bitflippersanonymous/fpga-camera/docs/Presentation.pdf

## FPGA Based Digital Camera

Ryan Henderson
February 10, 2013

## Digital Imaging

λ Real time video capture
λ CMOS Image Sensor
λ FPGA
λ External Memory
λ PC or Monitor Display
λ Image Sensor Evaluation Kit

## Presentation Overview

λ External Hardware
– Image Sensor
– XSA-100

λ FPGA Design
– Parallel Port
– Master Control
– Memory Control
– SDRAM
– I2C
– Image Sensor Data
Reader

λ Host PC Software
– Save Pictures as JPG /
BMP
– Control Image Sensor

## External Hardware

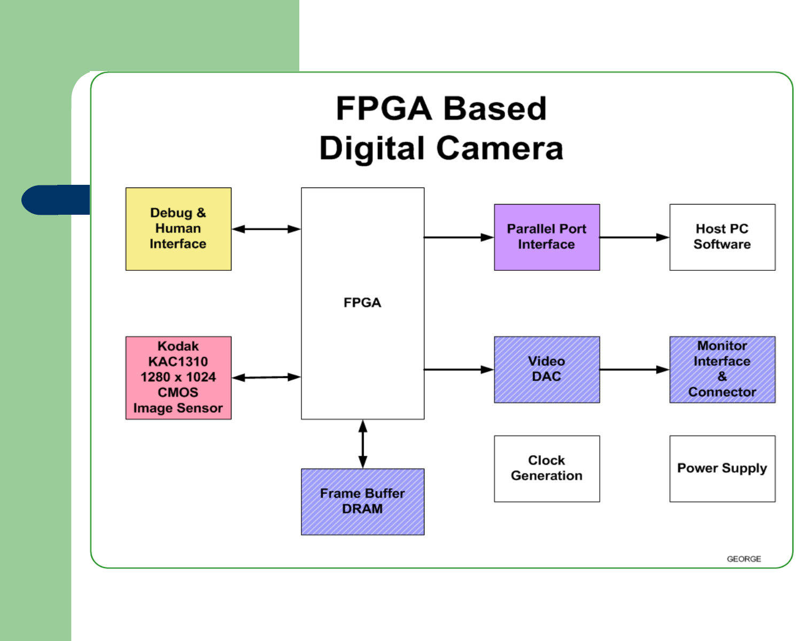
[picture p13: page 5]

## Image Sensor

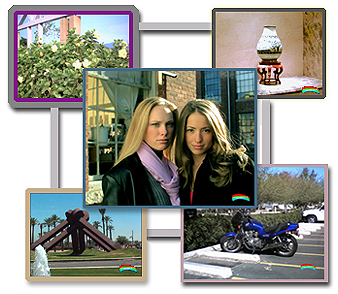
[picture p14: figure]

λ Motorola ImageMOS TM
MCM20027

λ Kodak Digital Science TM KAC – 1310

## Image Sensor Features

λ 1280 x 1024 Pixels Resolution
λ Continuous / Single Shutter Modes
λ 10-bit, RSD ADC Analog to Digital Converter
λ 48-pin Ceramic LCC Package
λ Digitally Programmable via I2C Interface
λ 10/15 fps full SXGA at 13/20Mhz Master Clock Rate λ Bayer-RGB Color Filter Array
λ 3.3V Analog and 3.3V Digital at 250mW Operation λ Camera on a Chip

## Feature Notes

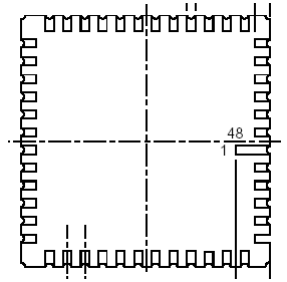
[picture p15: figure]

λ 1280 x 1024 x 10bits x 15fps = 196 608 000 Mbps
λ Sub sample and window of interest (WOI)
λ Surface mount Leadless
Chip Carrier

## Plastronics Socket

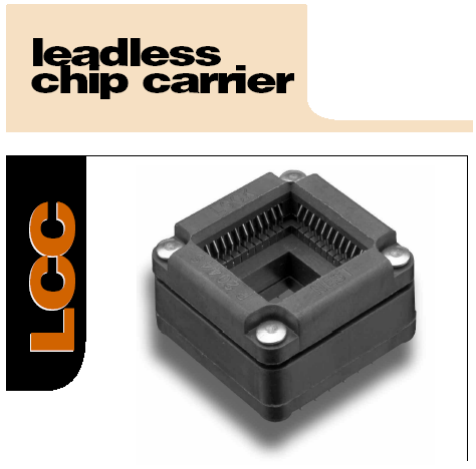
[picture p16: figure]

λ Zero insertion force
λ Strange bottom pin out
λ Required adaptor to .1”
hole spacing
λ Only socket available
under $250

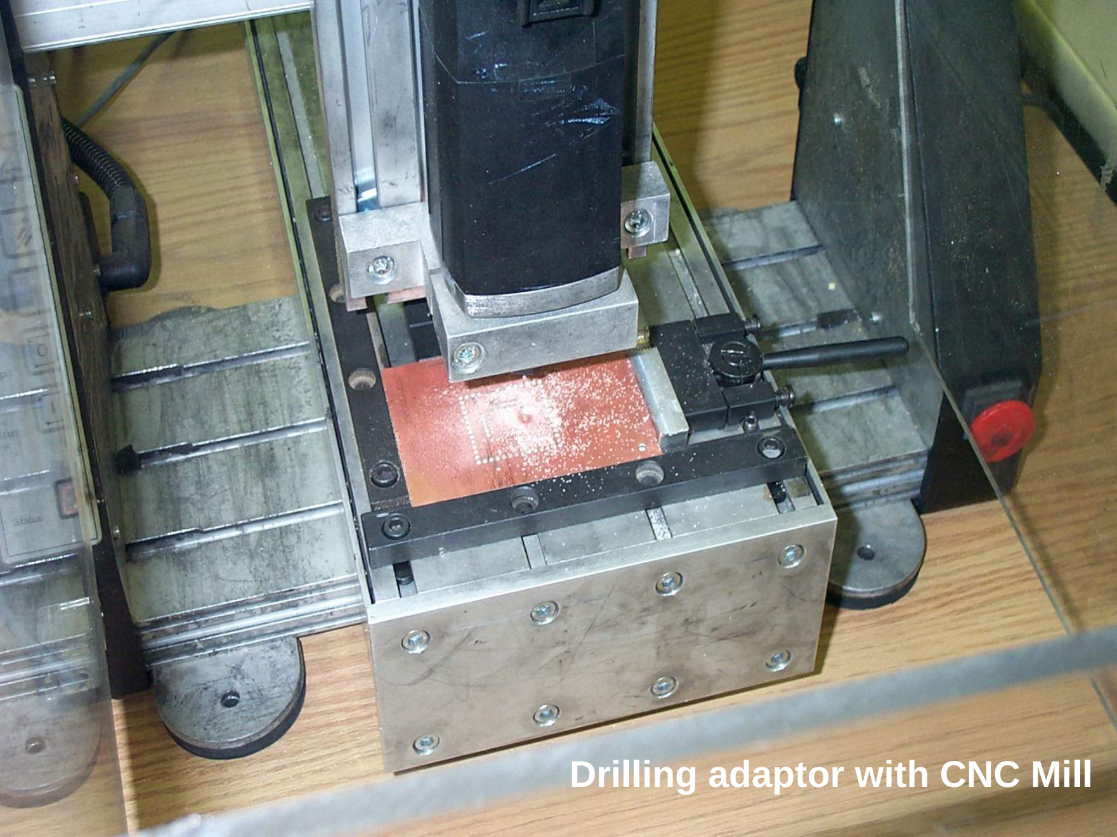
[picture p17: page 10]

Drilling adaptor with CNC Mill

## Sunex Lens

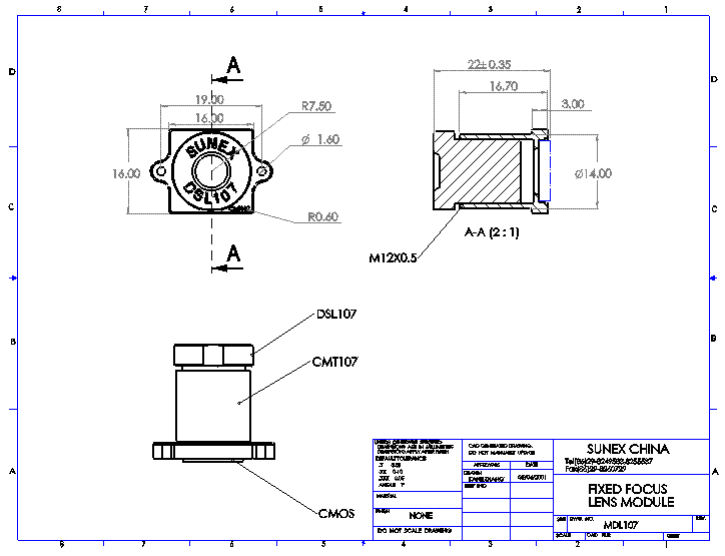
[picture p18: figure]

λ Blurry image
without lens
λ Matches
– F stop
– Focal Length
– Center of Sensor
λ Plastic

## Bayer RBG Color Microlenses

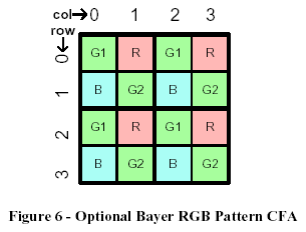
[picture p19: figure]

λ Twice as many green
pixels

λ Combine set of 4 to get
RGB value

## Control Registers

λ 41 8-bit Registers
λ Analog adjustment
– Exposure, white balance etc λ Digital functions / sensor interface – Zoom, pan, sub-sample
λ Column offsets for WOI

## FPGA Development Board

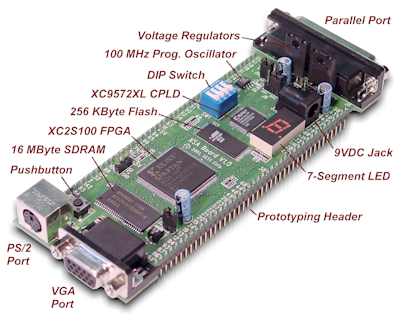
[picture p20: figure]

λ Xess XSA-100
λ Spartan 2
λ 16Mb SDRAM
λ 100MHz Osc.
λ Parallel Port
λ 84 Pin Prototype
Header

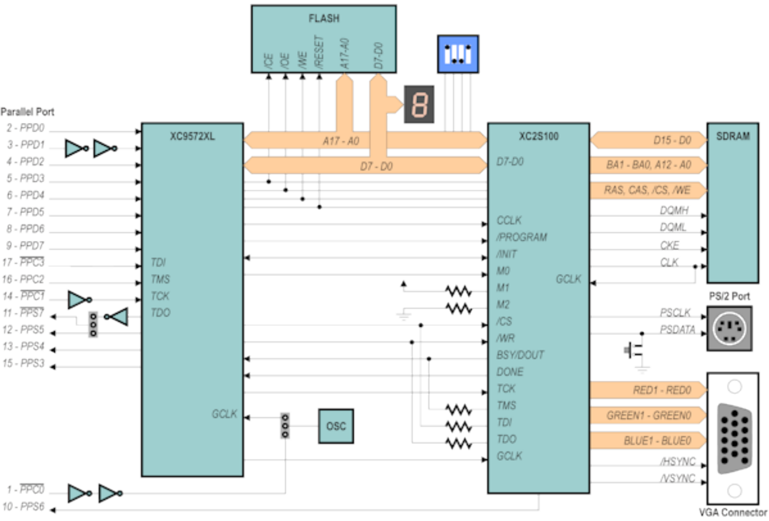
[picture p21: page 15]

## XC2S100 Spartan 2

λ 100k System Gates
λ 40k Bits Block SelectRAM+ λ 38k Distributed RAM
λ 4 Global Clocks
λ 4 Delay Locked Loops
λ 2.5V, 3.3V or 5V I/O
λ Altera Flex 10K70
– 4x Slower
– 18k total RAM

## SDRAM

λ Hynix HY57V281620A
λ 4 Banks x 2M x 16bits
λ PC133 CAS 2
λ External PCB Clock Feedback λ Prebuilt Xess VHDL Interface

## FPGA Design

## Planned Top Level

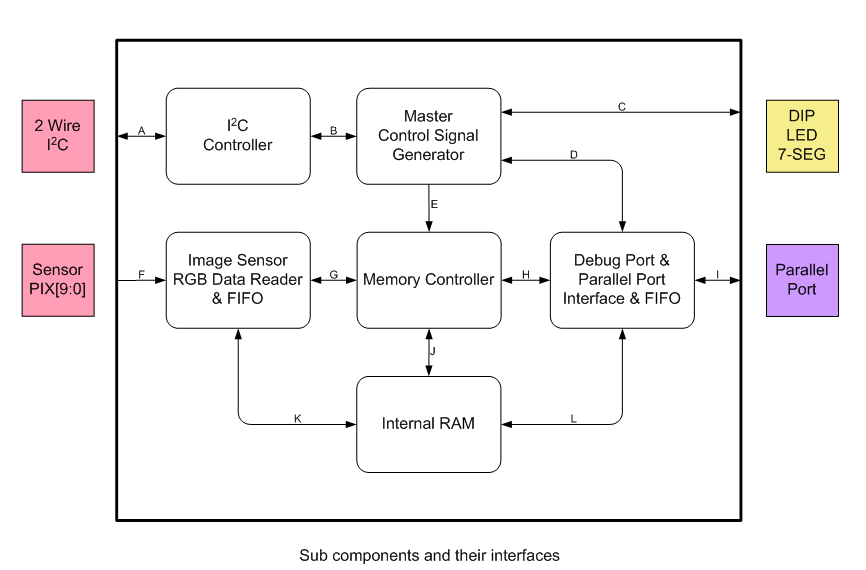
[picture p22: figure]

## Parallel Port Module

λ Connects through PLD to PC parallel port
λ 6 Download data lines d6 – d0
– Line d7 controls reconfiguration of Spartan λ 4 Upload Lines
λ Data Strobe controlled by PC
λ Receives commands from PC to:
– Set / Read registers in image sensor – Upload from RAM
λ 17,000 Gates

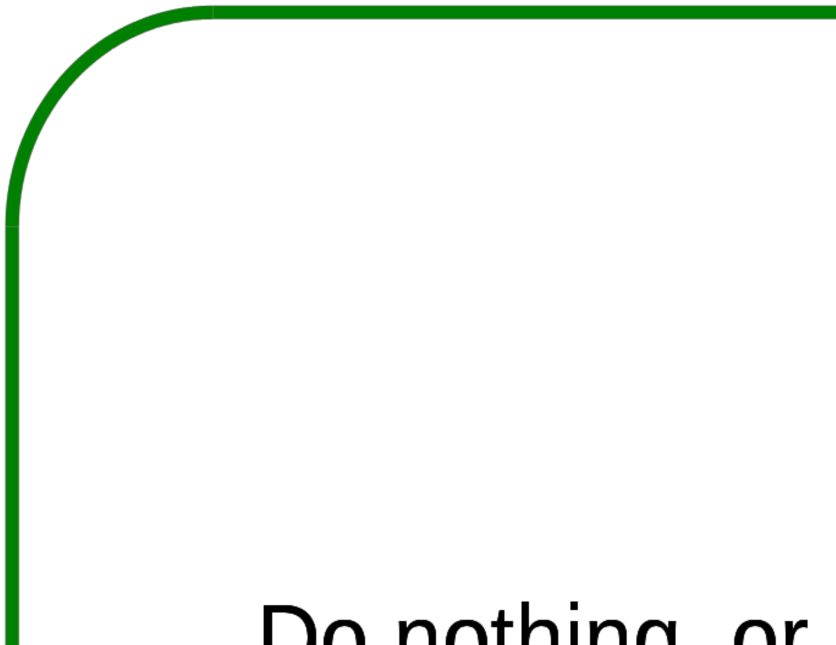
[picture p23: page 21]

## Parallel Port Upload

λ XSA-100 limitation, only upload using status pins λ Debounced strobe signal
λ DDR upload 4 bits / clock edge
λ ~150K bytes/sec
λ Asynchronous Coregen FIFO
– 16 bits 50MHz in
– 4 bits ~75kHz out
λ Counter determines memory addresses

## Parallel Port Download

λ Commands and addresses received
λ Latched and sent to Master Control Signal Generator

## Master Control Signal Generator

λ State machine
λ Branches to receive commands from PC λ Controls Memory Controller
– Sends start address, end address for upload λ Relay data between PC and image sensor through I2C interface

## Memory Controller

λ Arbitration between different components that access the memory
λ Interleaved memory read and write operations
λ Connected to internal RAM or SDRAM controller

## SDRAM Controller

λ Sample VHDL code from XESS
– 100ns Access
– No Burst Mode
– Incorrectly set Mode Register
λ If then else state machine implementation λ Example of DLL use
λ Modify to fit project needs
λ 16, 000 Gates

## SDRAM Controller Problems

λ Errors in code
λ Would synthesize in Leonardo but fail Xilinx place and route
λ Had to move I/O buffer instantiations to top level

I2C

λ CoolRunner XPLA3 I2C bus controller implementation from Xilinx
λ App note XAPP333
λ Microcontroller interface
– Write / Read from registers using bus cycles
– Similar to Wishbone common interface from Open Cores
λ Includes test benches
λ 2000 Gates I2C plus 4000 Gates my controller

## I2C Block Diagram

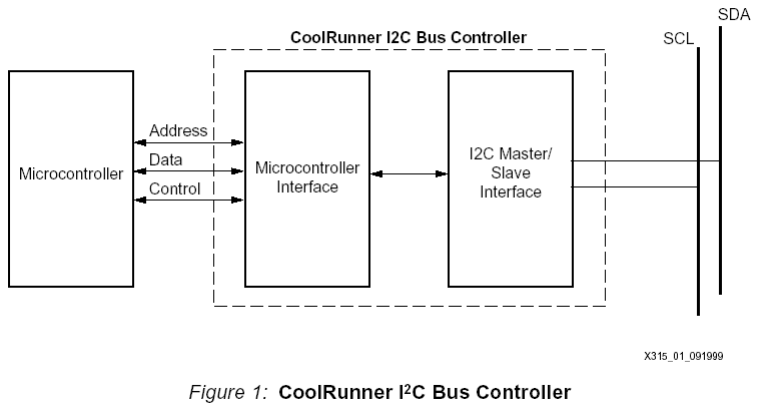
[picture p24: figure]
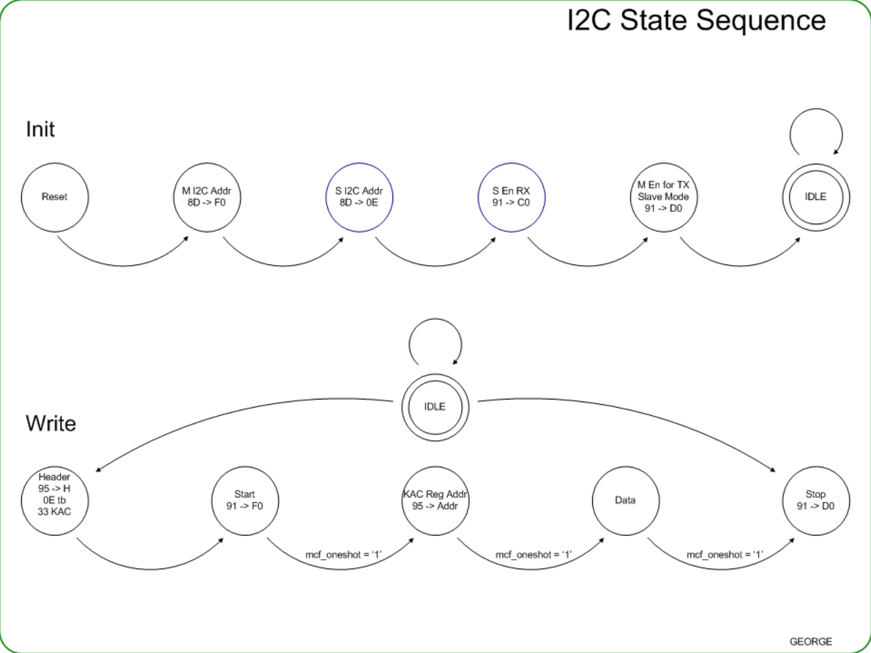
[picture p25: page 30]

## I2C Test Bench

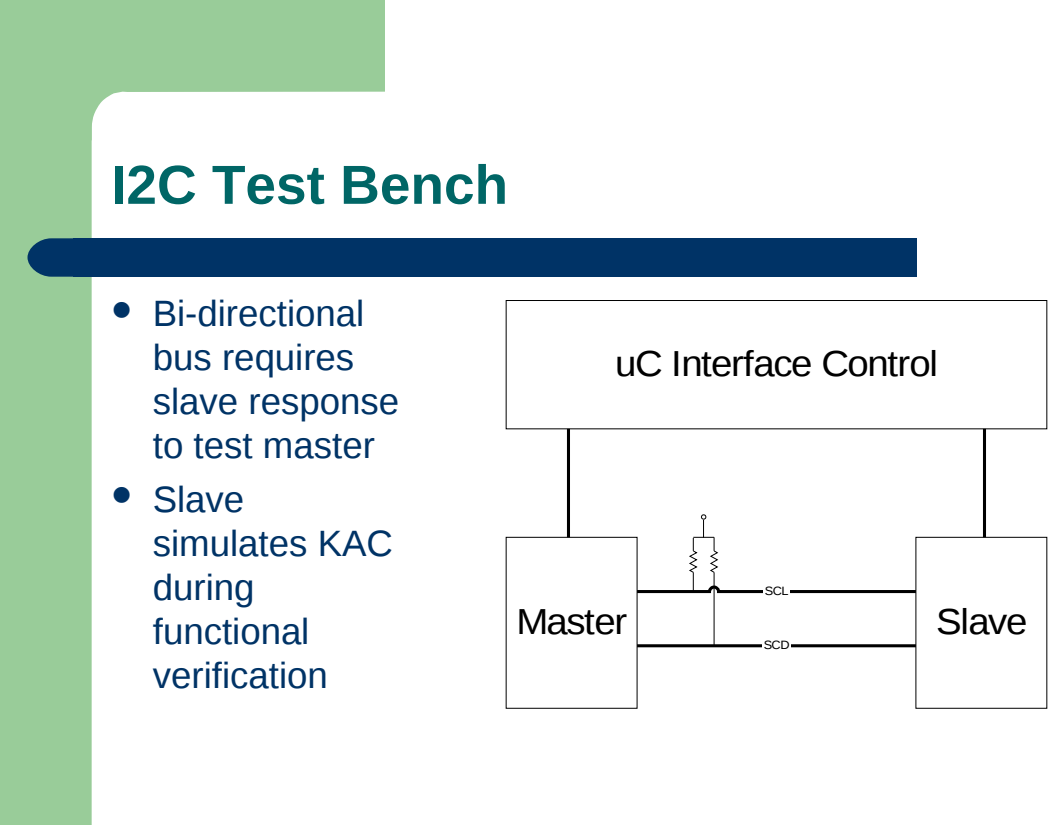
[picture p26: page 31]
Master; Slave; SCL; SCD

λ Bi-directional
bus requires
slave response
to test master
λ Slave
simulates KAC
during
functional
verification

uC Interface Control

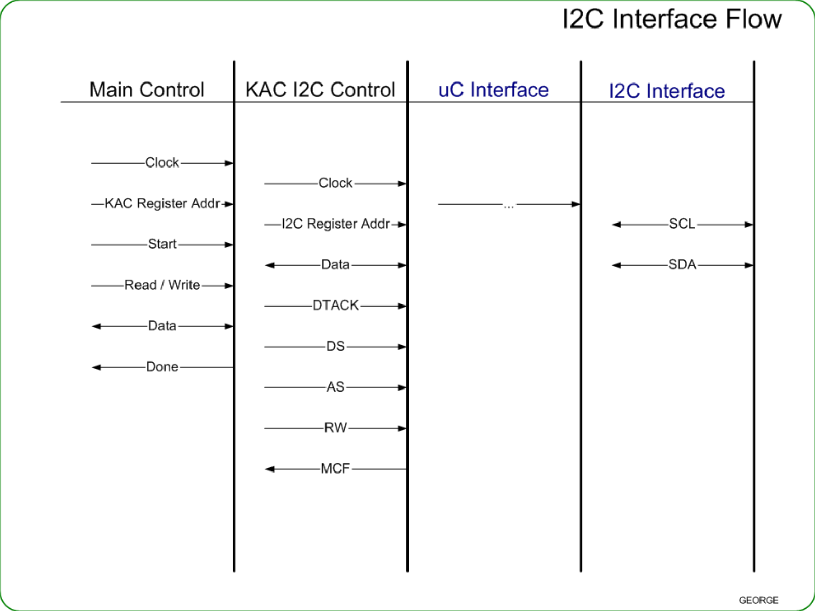
[picture p27: page 32]

## Image Sensor Data Reader

λ Transfer data from image sensor to FPGA λ 5 bits / Pixel
λ 1 pixel / 12MHz clock
λ FIFO between Image sensor and memory λ Handle timing for image sensor signals λ Convert Bayer pattern to RGB values
– Buffer pairs of lines
λ 20,000 Gates with FIFO and Buffers

## Host PC Software

λ Control parallel port transfers
λ Save uploaded pixel data as JPG or BMP λ Read and write image sensor register values λ GUI spring term
– Implement live video

## Conclusion

## External Hardware Summary

λ 1280x1024 Kodak CMOS Image Sensor λ XESS XSA-100 FPGA Board
– 100k Gate Spartan 2
– 16M bytes SDRAM
– Parallel Port

## FPGA Design Summary

λ Parallel port
λ SDRAM controller
λ Memory read write arbitrator λ I2C
λ RGB data conversion
λ 80, 000 Gates total

## Schedule

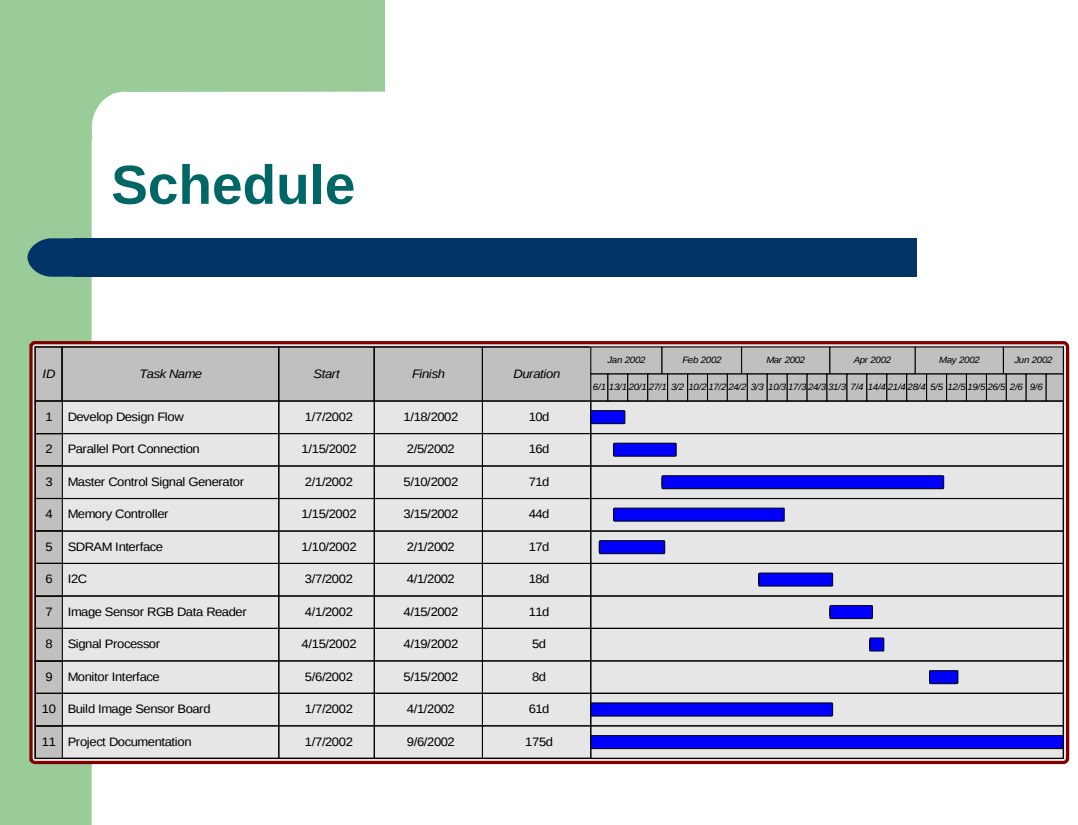
[picture p28: page 38]
Task Name; Start; Finish; Duration; Jan 2002; Feb 2002; Mar 2002; 2 Parallel Port Connection; 3 Master Control Signal Generator; 4 Memory Controller; 5 SDRAM Interface; Apr 2002; May 2002; Jun 2002; 11 Project Documentation; 10 Build Image Sensor Board; 9 Monitor Interface; 8 Signal Processor; 7 Image Sensor RGB Data Reader; 1 Develop Design Flow

## Sources

λ Xilinx www.xilinx.com

λ XESS www.xess.com

λ Hynix www.hynix.com

λ Motorola e-www.motorola.com

λ Kodak www.kodak.com/US/en/digital/ccd/sensorsMain.shtml

λ Plastronics www.locknest.com
λ Comp.arch.fpga
